bainazarseitek/project_mae_303/references/parts-photo.jpg

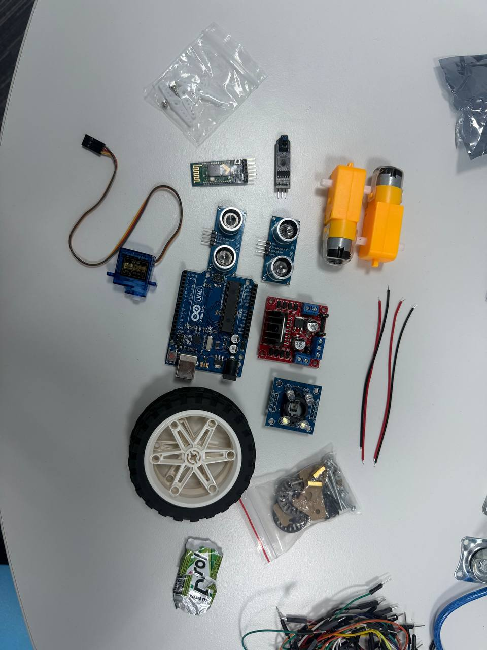
references/parts-photo.jpg
