bainazarseitek/project_mae_303/electronics/robot_bench/wiring-two-motors.png

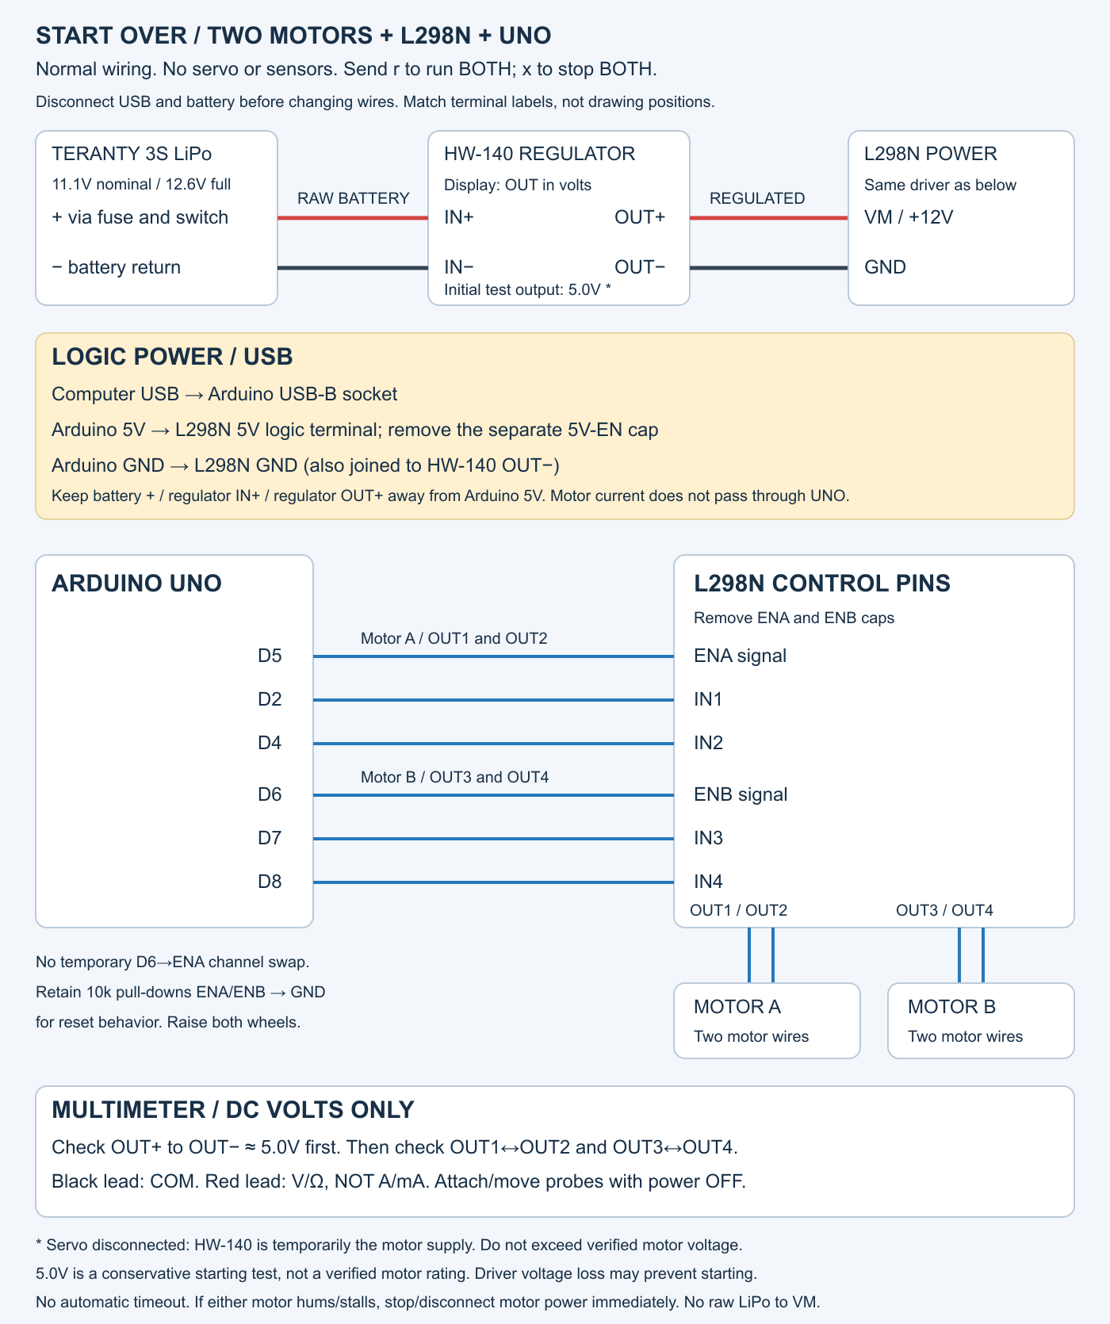
electronics/robot_bench/wiring-two-motors.png
