bainazarseitek/project_mae_303/electronics/sensor-wiring.png

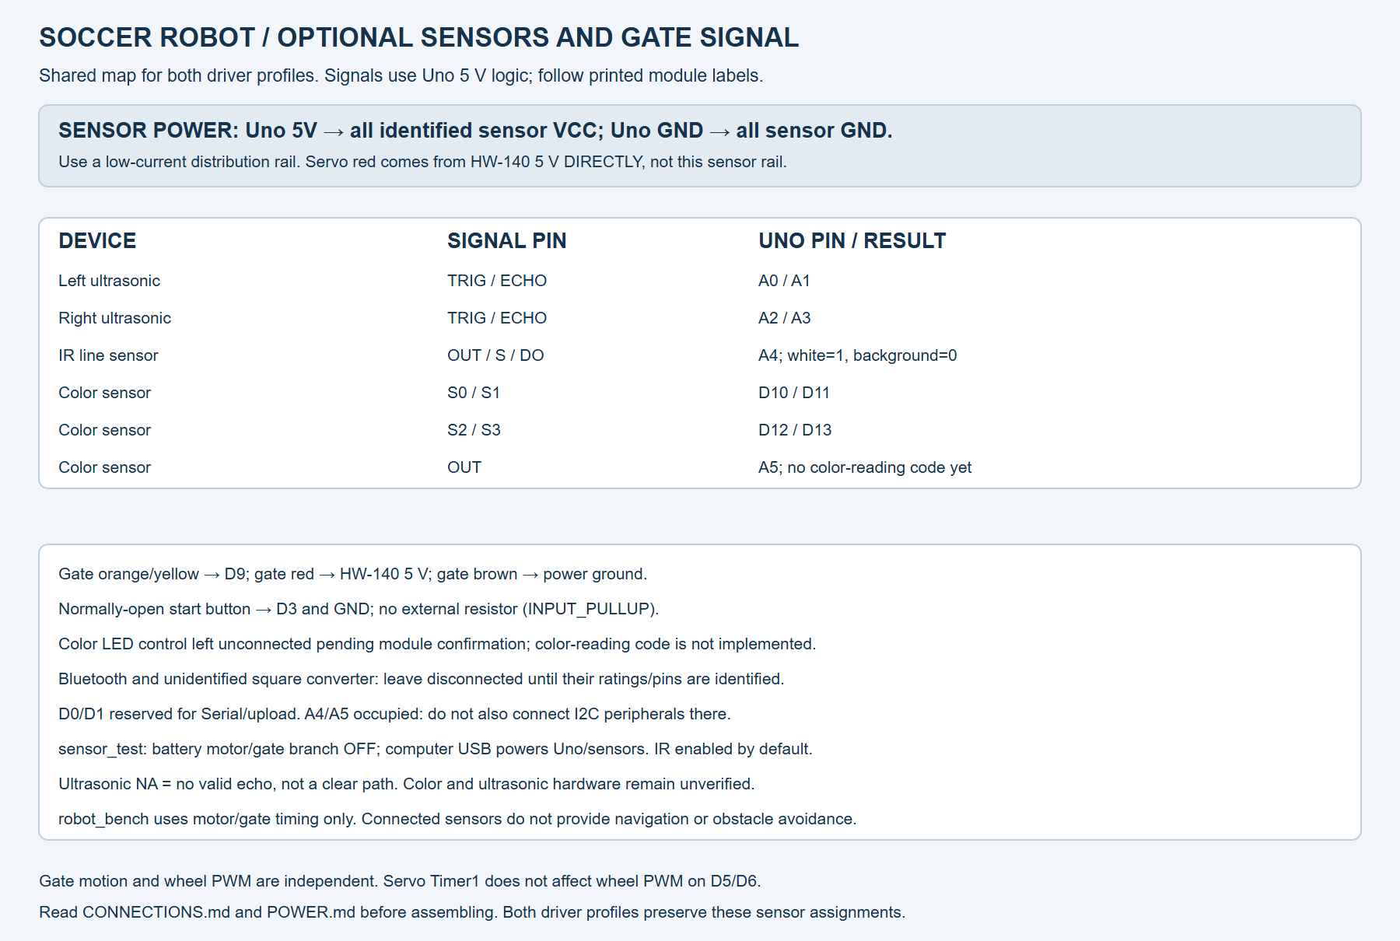
electronics/sensor-wiring.png
