bainazarseitek/project_mae_303/electronics/wiring-l298n.png

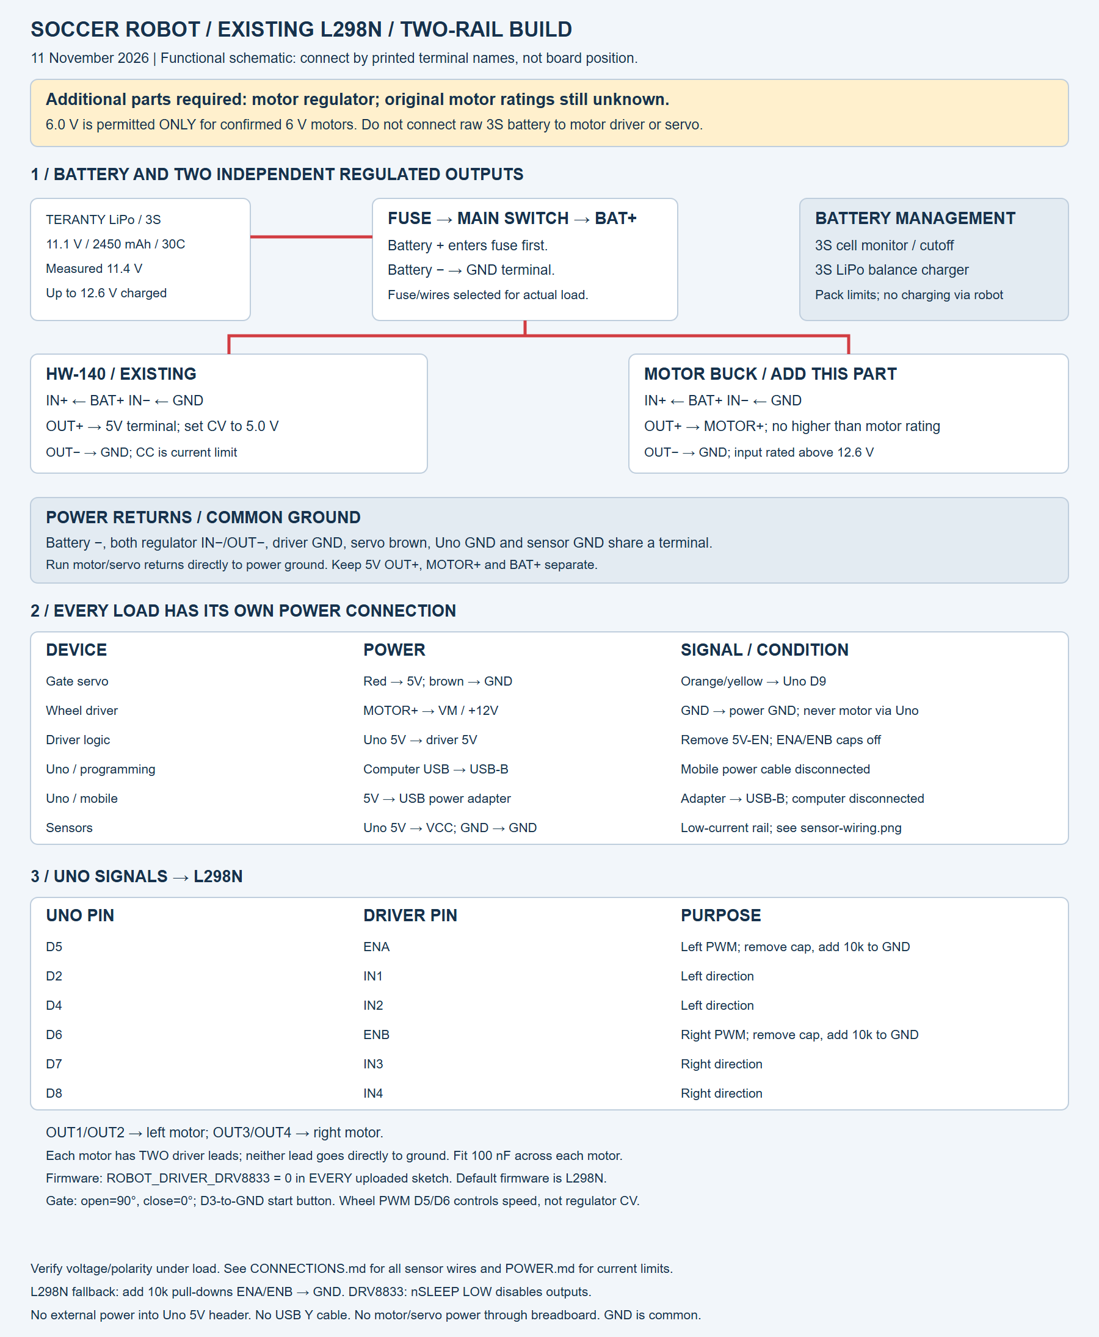
electronics/wiring-l298n.png
