bainazarseitek/project_mae_303/electronics/wiring.png

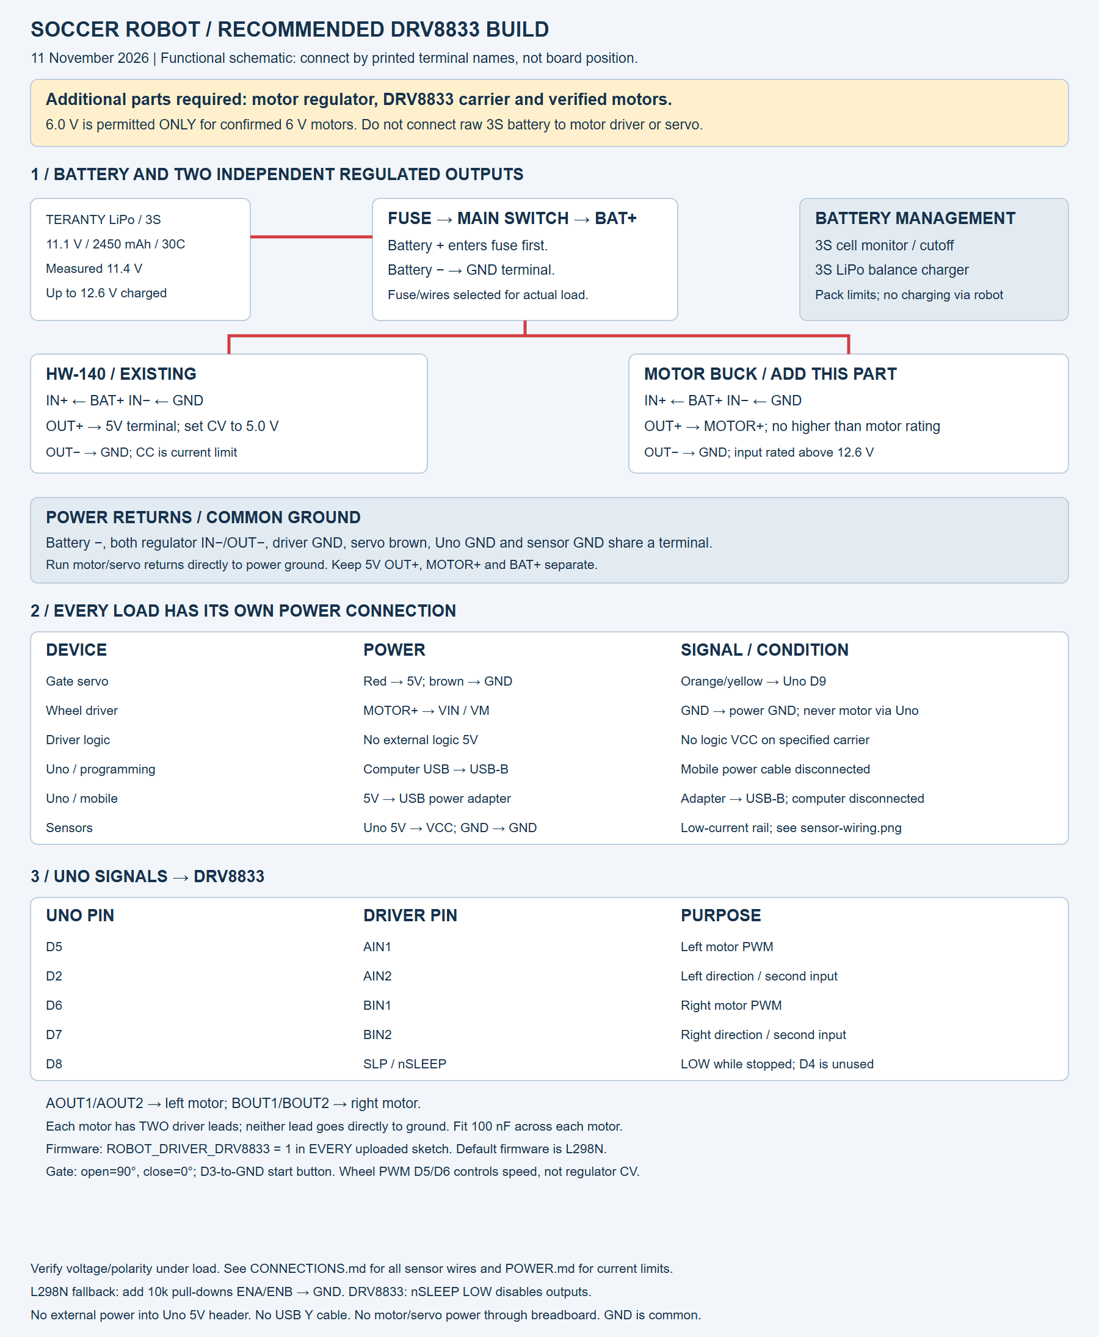
electronics/wiring.png
