bainazarseitek/project_mae_303/(commit log)

2026-11-07 Add soccer robot electronics setup, wiring and Arduino starter code
2026-11-09 Add gate and sensor test sketches with wiring and bench progress
2026-11-11 Update gate control, wiring and bench progress
2026-11-11 Refactor robot power wiring, hardware profiles and build documentation
    [connections.csv]
2026-11-11 Reset robot bench to continuous two-motor test with wiring guide
    [Arduino.h, robot_bench.ino, robot_bench_checks.cpp]
